cuspaceflight/avionics14/README.md

# CUSF Avionics 2014

## Firmware Compilation

Designed to be compiled with the GNU ARM Toolchain - https://launchpad.net/gcc-arm-embedded

The project should simply compile with

    make
