cuspaceflight/avionics14/TO_CHECK.md

# Badger 3 Testing List

## Things That Are Ok
* Magno
* Accel
* Baro
* LEDs
* Buzzer (with resistor removed)
* Pyro channels
* Radio

## Untested
* SD Card
* GPS

## Issues
* Gyro not responding on I2C
