cuspaceflight/avionics14/docs/states.png

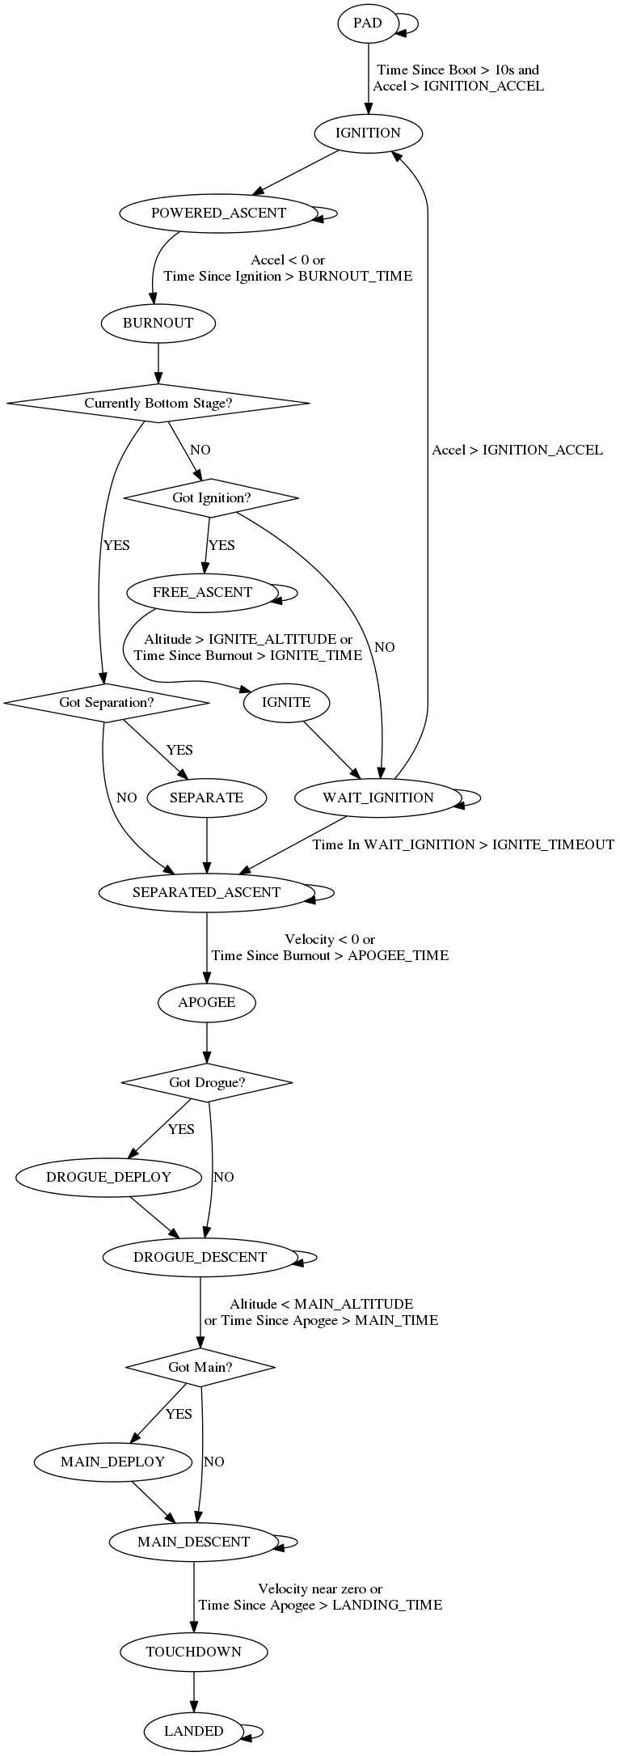
docs/states.png
