cuspaceflight/avionics14/pcb/pcbcase.dxf

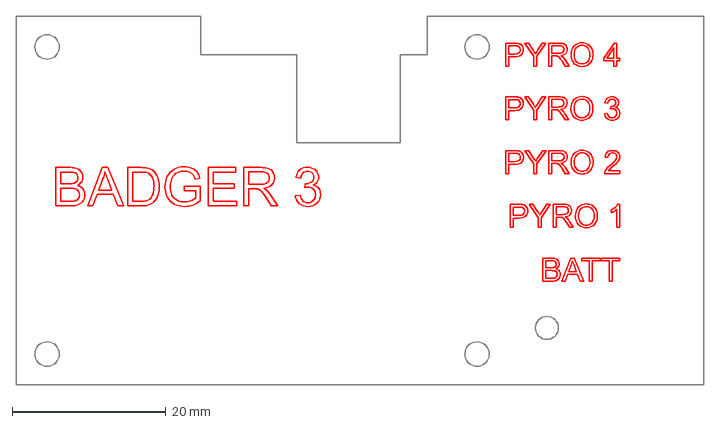
[picture p9: CAD file, 2015-06-05]
pcb/pcbcase.dxf
89.5 x 48.0 mm
