cuspaceflight/avionics14/firmware/tests/README.md

We should have some tests at some point ...
