cuspaceflight/avionics14/(threads)

Thread 13 (2015-08-19):

Race condition fix probably worse than cure

adamgreig, 2015-08-19:
https://github.com/cuspaceflight/avionics14/blob/master/firmware/adxl3x5.c#L282-L286

Looks like we lock before sleeping and hold the lock until we wake up from timeout. Should be enough to just have the interrupt check the thread it has a handle on is not already awake.
