cuspaceflight/avionics14/pcb/avionics.kicad_pcb

## KiCad design pcb/avionics.kicad_pcb (2015-05-06)

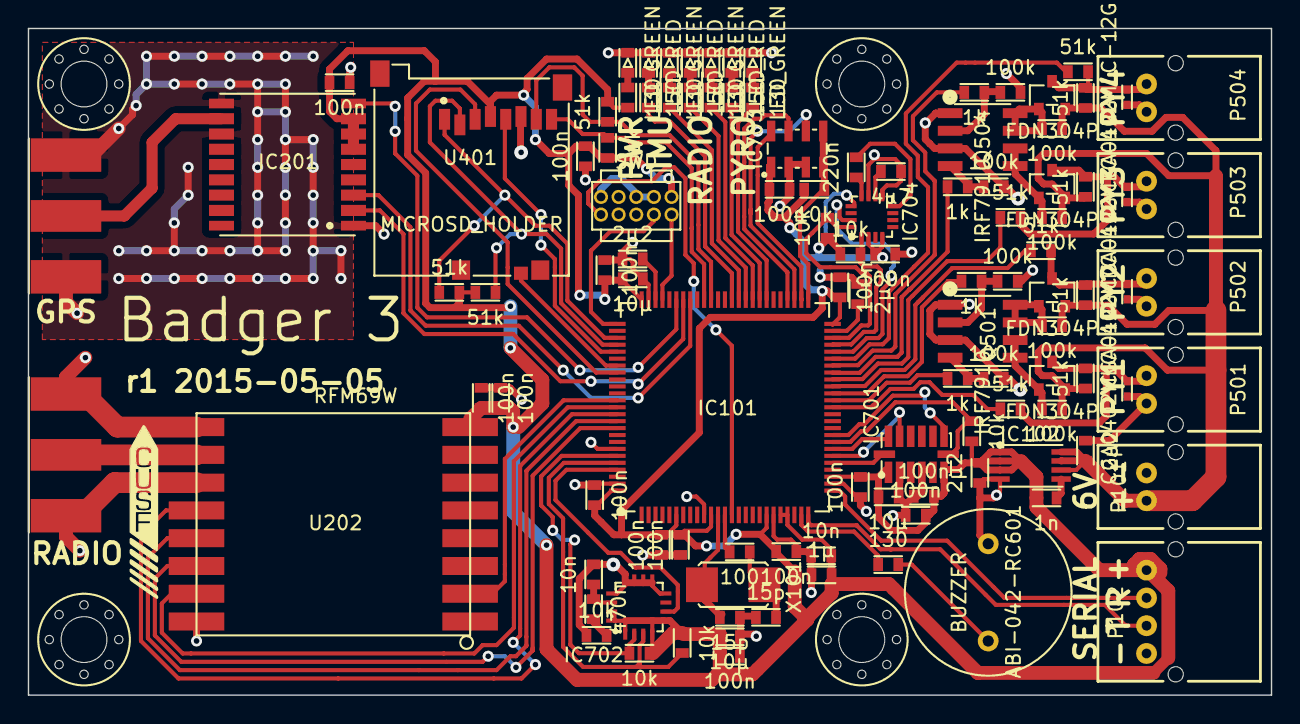
[picture p10: board avionics.kicad_pcb from above]

Board: 2 copper layers, 89.5 x 48.0 mm, 113 parts (0 on the bottom side), 86 nets.

Parts:
ABI-042-RC601: BUZZER; ABI-042-RC
C101, C701, C702: 10µ; 0603
C102, C103, C105, C109, C110, C112, C114, C201, C203, C204, C401, C703, C704, C705, C708, C709: 100n; 0603
C104: 1µ; 0603
C106, C107: 15p; 0603
C108, C706: 10n; 0603
C111, C113, C115, C117: 2µ2; 0603
C116: 1n; 0603
C707: 470n; 0603
C710: 4µ7; 0603
C711: 220n; 0603
D501, D502, D503, D504: CGA0402MLC-12G; R0402
D601, D603, D605, D607: LED_GREEN; 0603_LED
D602, D604, D606: LED_RED; 0603_LED
IC101: STM32F405VGT; LQFP100
IC102: ADP3335; MSOP8
IC201: MAX-7Q
IC701: ADXL345; ADXL3x5
IC702: L3G4200D
IC703: MS5611-01BA03; MS5611-01BA
IC704: HMC5883L
M3_MOUNT, M3_MOUNT#2, M3_MOUNT#3, M3_MOUNT#4: VAL**; M3_MOUNT
P101, P501, P502, P503, P504: CONN_01X02; S02B-PASK-2
P102: CONN_01X04; S04B-PASK-2
P103: SWD; FTSH-105-01-F-D-K
P201, P202: SMA; SMA-142-0701-801
Q501, Q504: IRF7910; SO-8
Q502, Q503, Q505, Q506: FDN304P; SOT23
R101: 100; 0603
R401, R402, R403, R404, R507, R508, R509, R510, R517, R518, R519, R520: 51k; 0603
R501, R502, R511, R512: 1k; 0603
R503, R504, R505, R506, R513, R514, R515, R516: 100k; 0603
R601, R603, R605, R607, R608: 130; 0603
R602, R604, R606: 150; 0603
R701, R702, R703, R704, R705, R706, R707: 10k; 0603
U202: RFM69W; rfm69w
U401: MICROSD_HOLDER; MEM2051
X101: 8M; XTAL50x32

Connections:
+3V3: C101.1, C102.1, C103.1, C104.1, C105.1, C108.1, C109.1, C110.1, C112.1, C114.1, C116.1, C117.1, C201.1, C203.1, C204.1, C401.1, C701.1, C702.1, C703.1, C704.1, C705.1, C708.1, C709.1, IC101.6, IC101.11, IC101.19, IC101.21, IC101.22, IC101.28, IC101.50, IC101.75, IC101.100, IC102.1, IC102.2, IC102.3, IC201.6, IC201.7, IC201.8, IC701.1, IC701.6, IC702.1, IC702.4, IC702.5, IC702.15, IC702.16, IC703.1, IC704.2, IC704.4, IC704.13, P102.1, P103.1, R401.1, R402.1, R403.1, R404.1, R607.1, R701.2, R702.2, R703.1, R705.2, R706.1, R707.2, U202.8, U401.4
+BATT: C115.1, IC102.6, IC102.7, IC102.8, P101.2, Q502.2, Q503.2, Q505.2, Q506.2, R505.2, R506.2, R507.2, R508.2, R515.2, R516.2, R517.2, R518.2
/Datalogging & Pyros/BUZZER: IC101.24, R608.2
/Datalogging & Pyros/IMU_OK: IC101.61, R603.1
/Datalogging & Pyros/PY1_TRG: IC101.39, R501.1
/Datalogging & Pyros/PY2_TRG: IC101.40, R511.1
/Datalogging & Pyros/PY3_TRG: IC101.43, R502.1
/Datalogging & Pyros/PY4_TRG: IC101.44, R512.1
/Datalogging & Pyros/PY_OK: IC101.57, R601.1
/Datalogging & Pyros/RADIO_OK: IC101.59, R605.1
/Datalogging & Pyros/~IMU_OK: IC101.62, R604.1
/Datalogging & Pyros/~PY1_CHK: IC101.38, R509.2
/Datalogging & Pyros/~PY2_CHK: IC101.41, R519.2
/Datalogging & Pyros/~PY3_CHK: IC101.42, R510.2
/Datalogging & Pyros/~PY4_CHK: IC101.45, R520.2
/Datalogging & Pyros/~PY_OK: IC101.58, R602.1
/Datalogging & Pyros/~RADIO_OK: IC101.60, R606.1
/Datalogging & Pyros/µSD_CD: IC101.82, U401.9
/Datalogging & Pyros/µSD_CLK: IC101.80, U401.5
/Datalogging & Pyros/µSD_CMD: IC101.83, U401.3
/Datalogging & Pyros/µSD_DAT0: IC101.65, R401.2, U401.7
/Datalogging & Pyros/µSD_DAT1: IC101.66, R402.2, U401.8
/Datalogging & Pyros/µSD_DAT2: IC101.78, R403.2, U401.1
/Datalogging & Pyros/µSD_DAT3: IC101.79, R404.2, U401.2
/EXT_RX: IC101.26, P102.2
/EXT_TX: IC101.25, P102.3
/Inertial Measurement/ACCEL_CS: IC101.33, IC701.7, R703.2
/Inertial Measurement/ACCEL_INT: IC101.34, IC701.8
/Inertial Measurement/ACCEL_MISO: IC101.31, IC701.12
/Inertial Measurement/ACCEL_MOSI: IC101.32, IC701.13
/Inertial Measurement/ACCEL_SCK: IC101.30, IC701.14
/Inertial Measurement/BARO_CS: IC101.51, IC703.4, IC703.5, R706.2
/Inertial Measurement/BARO_MISO: IC101.53, IC703.6
/Inertial Measurement/BARO_MOSI: IC101.54, IC703.7
/Inertial Measurement/BARO_SCK: IC101.52, IC703.8
/Inertial Measurement/GYRO_DRDY: IC101.97, IC702.6
/Inertial Measurement/GYRO_SCL: IC101.95, IC702.2, R701.1
/Inertial Measurement/GYRO_SDA: IC101.96, IC702.3, R702.1
/Inertial Measurement/MAGNO_DRDY: IC101.46, IC704.15
/Inertial Measurement/MAGNO_SCL: IC101.47, IC704.1, R705.1
/Inertial Measurement/MAGNO_SDA: IC101.48, IC704.16, R707.1
/Radio/GPS_nRST: IC101.70, IC201.9
/Radio/RADIO_CLK: IC101.89, U202.12
/Radio/RADIO_CS: IC101.88, U202.15
/Radio/RADIO_IRQ: IC101.87, U202.2
/Radio/RADIO_MISO: IC101.90, U202.13
/Radio/RADIO_MOSI: IC101.91, U202.14
/Radio/RX: IC101.68, IC201.3
/Radio/TX: IC101.69, IC201.2
/SWDCLK: IC101.76, P103.4
/SWDIO: IC101.72, P103.2
/nReset: IC101.14, P103.10
GND: ABI-042-RC601.2, C101.2, C102.2, C103.2, C104.2, C105.2, C106.2, C107.2, C108.2, C109.2, C110.2, C111.2, C112.2, C113.2, C114.2, C115.2, C117.2, C201.2, C203.2, C204.2, C401.2, C701.2, C702.2, C703.2, C704.2, C705.2, C706.1, C708.2, C709.2, C710.2, D501.2, D502.2, D503.2, D504.2, D601.2, D602.2, D603.2, D604.2, D605.2, D606.2, D607.2, IC101.10, IC101.20, IC101.27, IC101.74, IC101.94, IC101.99, IC102.4, IC201.1, IC201.10, IC201.12, IC701.2, IC701.4, IC701.5, IC702.8, IC702.9, IC702.10, IC702.11, IC702.12, IC702.13, IC703.2, IC703.3, IC704.9, IC704.11, P101.1, P102.4, P103.3, P103.5, P103.9, P201.2, P201.3, P201.4, P201.5, P202.2, P202.3, P202.4, P202.5, P501.2, P502.2, P503.2, P504.2, Q501.1, Q501.3, Q504.1, Q504.3, R503.1, R504.1, R513.1, R514.1, R704.2, U202.9, U202.11, U202.16, U401.6
unnamed: ABI-042-RC601.1, R608.1
unnamed: C106.1, IC101.12, X101.1
unnamed: C107.1, R101.2, X101.2
unnamed: C111.1, IC101.49
unnamed: C113.1, IC101.73
unnamed: C116.2, IC102.5
unnamed: C706.2, C707.2, IC702.14
unnamed: C707.1, R704.1
unnamed: C710.1, IC704.10
unnamed: C711.1, IC704.8
unnamed: C711.2, IC704.12
unnamed: D501.1, P501.1, Q502.3, R507.1, R509.1
unnamed: D502.1, P502.1, Q505.3, R517.1, R519.1
unnamed: D503.1, P503.1, Q503.3, R508.1, R510.1
unnamed: D504.1, P504.1, Q506.3, R518.1, R520.1
unnamed: D601.1, R601.2
unnamed: D602.1, R602.2
unnamed: D603.1, R603.2
unnamed: D604.1, R604.2
unnamed: D605.1, R605.2
unnamed: D606.1, R606.2
unnamed: D607.1, R607.2
unnamed: IC101.13, R101.1
unnamed: IC201.11, P201.1
unnamed: P202.1, U202.10
unnamed: Q501.2, R511.2, R513.2
unnamed: Q501.4, R501.2, R503.2
unnamed: Q501.5, Q501.6, Q502.1, R505.1
unnamed: Q501.7, Q501.8, Q505.1, R515.1
unnamed: Q503.1, Q504.5, Q504.6, R506.1
unnamed: Q504.2, R512.2, R514.2
unnamed: Q504.4, R502.2, R504.2
unnamed: Q504.7, Q504.8, Q506.1, R516.1
