cuspaceflight/avionics14/firmware/ublox.c

/*
 * uBlox GPS receiver
 * M2R
 * 2014 Adam Greig, Cambridge University Spaceflight
 */

/*
 * TODO
 *
 * * Read large buffers up to the number of bytes available from the ublox
 * * Run each new byte through a decoding state machine
 * * SM calls various functions to deal with each type of received message
 * * * Either ACK/NAK, PVT, or perhaps also CFG-NAV5
 * * Should poll the device's NAV5 at least once to ensure flight mode
 * * PVT updates get sent to central dispatch
 * * ACKs are OK but receiving a NAK is cause for sadness and logs
 */

#include <stdlib.h>
#include <string.h>
#include "ublox.h"
#include "hal.h"
#include "datalogging.h"
#include "tweeter.h"

/* UBX sync bytes */
#define UBX_SYNC1 0xB5
#define UBX_SYNC2 0x62

/* UBX Classes */
#define UBX_NAV 0x01
#define UBX_RXM 0x02
#define UBX_INF 0x04
#define UBX_ACK 0x05
#define UBX_CFG 0x06
#define UBX_UPD 0x09
#define UBX_MON 0x0A
#define UBX_AID 0x0B
#define UBX_TIM 0x0D
#define UBX_MGA 0x13
#define UBX_LOG 0x21
#define NMEA_CLASS 0xF0

/* Selection of UBX IDs */
#define UBX_CFG_MSG  0x01
#define UBX_CFG_NAV5 0x24
#define UBX_NAV_PVT  0x07
#define NMEA_GGA 0x00
#define NMEA_GLL 0x01
#define NMEA_GSA 0x02
#define NMEA_GSV 0x03
#define NMEA_RMC 0x04
#define NMEA_VTG 0x05

/* UBX Decoding State Machine States */
typedef enum {
    STATE_IDLE = 0, STATE_SYNC1, STATE_SYNC2,
    STATE_CLASS, STATE_ID, STATE_L1, STATE_L2,
    STATE_PAYLOAD, STATE_PAYLOAD_DONE, STATE_CK_A,
    NUM_STATES
} ubx_state;

/* Structs for various UBX messages */

/* UBX-CFG-NAV5
 * Set navigation fix settings.
 * Notably includes changing dynamic mode to "Airborne 4G".
 */
typedef struct {
    union {
        uint8_t data;
        uint8_t sync1;
    };
    uint8_t sync2, class, id;
    uint16_t length;
    union {
        uint8_t payload[36];
        struct {
            uint16_t mask;
            uint8_t dyn_model;
            uint8_t fix_mode;
            int32_t fixed_alt;
            uint32_t fixed_alt_var;
            int8_t min_elev;
            uint8_t dr_limit;
            uint16_t p_dop, t_dop, p_acc, t_acc;
            uint8_t static_hold_thres;
            uint8_t dgps_timeout;
            uint8_t cno_thresh_num_svs, cno_thresh;
            uint16_t reserved;
            uint16_t static_hold_max_dist;
            uint8_t utc_standard;
            uint8_t reserved3;
            uint32_t reserved4;
        } __attribute__((packed));
    };
    uint8_t ck_a, ck_b;
} ubx_cfg_nav5_t;

/* UBX-CFG-MSG
 * Change rate (or disable) automatic delivery of messages
 * to the current port.
 */
typedef struct {
    union {
        uint8_t data;
        uint8_t sync1;
    };
    uint8_t sync2, class, id;
    uint16_t length;
    union {
        uint8_t payload[3];
        struct {
            uint8_t msg_class;
            uint8_t msg_id;
            uint8_t rate;
        } __attribute__((packed));
    };
    uint8_t ck_a, ck_b;
} ubx_cfg_msg_t;

/* UBX-ACK
 * ACK/NAK messages after trying to set a config.
 */
typedef struct {
    union {
        uint8_t data;
        uint8_t sync1;
    };
    uint8_t sync2, class, id;
    uint16_t length;
    union {
        uint8_t payload[2];
        struct {
            uint8_t cls_id;
            uint8_t msg_id;
        } __attribute__((packed));
    };
    uint8_t ck_a, ck_b;
} ubx_ack_t;

/* UBX-NAV-PVT
 * Contains fix quality, position and time information.
 * Everything you want in one message.
 */
typedef struct {
    union {
        uint8_t data;
        uint8_t sync1;
    };
    uint8_t sync2, class, id;
    uint16_t length;
    union {
        uint8_t payload[92];
        struct {
            uint32_t i_tow;
            uint16_t year;
            uint8_t month, day, hour, minute, second;
            uint8_t valid;
            uint32_t t_acc;
            int32_t nano;
            uint8_t fix_type;
            uint8_t flags;
            uint8_t reserved1;
            uint8_t num_sv;
            int32_t lon, lat;
            int32_t height, h_msl;
            uint32_t h_acc, v_acc;
            int32_t velN, velE, velD, gspeed;
            int32_t head_mot;
            uint32_t s_acc;
            uint32_t head_acc;
            uint16_t p_dop;
            uint16_t reserved2;
            uint32_t reserved3;
            int32_t head_veh;
            uint32_t reserved4;
        } __attribute__((packed));
    };
    uint8_t ck_a, ck_b;
} ubx_nav_pvt_t;

static void ublox_warn(const uint8_t n)
{
    uint8_t i;
    for(i=0; i<n; i++) {
        palSetPad(GPIOD, GPIOD_RADIO_RED);
        chThdSleepMilliseconds(100);
        palClearPad(GPIOD, GPIOD_RADIO_RED);
        chThdSleepMilliseconds(200);
    }
}

static void ublox_error(const uint8_t n)
{
    tweeter_set_error(ERROR_GPS, true);
    while(1) {
        ublox_warn(n);
    }
}

/* Computes the Fletcher-8 checksum over buf, using its length fields
 * to determine how much to read and where to insert the new checksum.
 */
static void ublox_checksum(uint8_t *buf)
{
    uint16_t plen, i;
    uint8_t ck_a = 0x00, ck_b = 0x00;

    /* Check SYNC bytes are correct */
    if(buf[0] != UBX_SYNC1 && buf[1] != UBX_SYNC2)
        return;

    /* Extract payload length */
    plen = ((uint16_t*)buf)[2];

    /* Run Fletcher-8 algorithm */
    for(i=2; i<plen+6; i++) {
        ck_a += buf[i];
        ck_b += ck_a;
    }

    /* Write new checksum to the buffer */
    buf[plen+6] = ck_a;
    buf[plen+7] = ck_b;
}

/* Transmit a UBX message over the serial port.
 * Message length is determined from the UBX length field.
 * Checksum is added automatically.
 */
static bool_t ublox_transmit(uint8_t *buf)
{
    size_t n;
    systime_t timeout;

    /* Add checksum to outgoing message */
    ublox_checksum(buf);

    /* Determine length and thus suitable timeout in systicks (ms) */
    n = 8 + ((uint16_t*)buf)[2];
    timeout = n / 100 + 10;

    /* Transmit message */
    return sdWriteTimeout(&SD1, buf, n, timeout) == n;
}

/* Attempt to read one or more messages from the uBlox.
 * Returns 0 if no messages were read, else returns the number of bytes
 * read. Will read at most bufsize bytes into buf.
 */
static size_t ublox_receive(uint8_t *buf, size_t bufsize)
{
    return sdReadTimeout(&SD1, buf, bufsize, TIME_IMMEDIATE);
}

/* Run the first `num_new_bytes` bytes in `buf` through the UBX decoding state
 * machine. Note that this function preserves static state and dispatches new
 * messages as appropriate once received.
 */
static void ublox_state_machine(uint8_t *buf, size_t num_new_bytes)
{
    size_t i;
    static ubx_state state = STATE_IDLE;

    static uint8_t class, id;
    static uint16_t length;
    static uint16_t length_remaining;
    static char payload[128];
    static uint8_t ck_a, ck_b;

    ubx_cfg_nav5_t cfg_nav5;
    ubx_nav_pvt_t nav_pvt;
    ublox_pvt_t pvt;
    
    for(i = 0; i < num_new_bytes; i++) {
        uint8_t b = buf[i];

        switch(state) {
            case STATE_IDLE:
                if(b == UBX_SYNC1)
                    state = STATE_SYNC1;
                break;

            case STATE_SYNC1:
                if(b == UBX_SYNC2)
                    state = STATE_SYNC2;
                else
                    state = STATE_IDLE;
                break;

            case STATE_SYNC2:
                class = b;
                state = STATE_CLASS;
                break;

            case STATE_CLASS:
                id = b;
                state = STATE_ID;
                break;

            case STATE_ID:
                length = (uint16_t)b;
                state = STATE_L1;
                break;

            case STATE_L1:
                length |= (uint16_t)b << 8;
                if(length >= 128) {
                    state = STATE_IDLE;
                }
                length_remaining = length;
                state = STATE_PAYLOAD;
                break;

            case STATE_PAYLOAD:
                if(length_remaining)
                    payload[length - length_remaining--] = b;
                else
                    state = STATE_PAYLOAD_DONE;
                break;
            
            case STATE_PAYLOAD_DONE:
                ck_a = b;
                state = STATE_CK_A;
                break;

            case STATE_CK_A:
                ck_b = b;
                (void)ck_a;
                (void)ck_b;
                /* TODO check checksum */
                state = STATE_IDLE;
                switch(class) {
                    case UBX_ACK:
                        if(id == 0x00) {
                            /* NAK */
                            /* TODO be very sad */
                            ublox_error(3);
                        } else if(id == 0x01) {
                            /* ACK */
                            /* No need to do anything */
                        } else {
                            /* TODO SAD */
                            ublox_error(3);
                        }
                        break;
                    case UBX_NAV:
                        if(id == 0x07) {
                            /* PVT */
                            memcpy(nav_pvt.payload, payload, length);
                            memcpy(&pvt, payload, length);
                            palSetPad(GPIOD, GPIOD_RADIO_GRN);
                            chThdSleepMilliseconds(100);
                            palClearPad(GPIOD, GPIOD_RADIO_GRN);
                            log_u8(CHAN_GPS_TIME,
                                   (uint8_t)(pvt.year & 0xFF),
                                   (uint8_t)(pvt.year>>8 & 0xFF),
                                   pvt.month, pvt.day, pvt.hour, pvt.minute,
                                   pvt.second, pvt.valid);
                            log_s32(CHAN_GPS_POS, pvt.lat, pvt.lon);
                            log_s32(CHAN_GPS_ALT, pvt.height, pvt.h_msl);
                            log_s8(CHAN_GPS_STATUS, pvt.fix_type, pvt.flags,
                                   pvt.num_sv, 0, 0, 0, 0, 0);
                            /* Send the PVT to dispatch */
                            /*dispatch_pvt(pvt);*/
                        } else {
                            /* TODO SAD */
                            ublox_error(3);
                        }
                        break;
                    case UBX_CFG:
                        if(id == 0x24) {
                            /* NAV5 */
                            memcpy(cfg_nav5.payload, payload, length);
                            /* Just check that Airborne is set, if not log a
                             * warning and try to set it again */
                        } else {
                            /* TODO SAD */
                            ublox_error(3);
                        }
                        break;
                    default:
                        /* TODO sad */
                        ublox_error(3);
                        break;
                }
                break;

            default:
                state = STATE_IDLE;
                /* TODO sad */
                ublox_error(3);
                break;

        }
    }
}

static bool_t ublox_init(void)
{
    ubx_cfg_nav5_t nav5;
    ubx_cfg_msg_t msg;
    bool_t success = TRUE;

    /* Set to Airborne <4g dynamic mode */
    nav5.sync1 = UBX_SYNC1;
    nav5.sync2 = UBX_SYNC2;
    nav5.class = UBX_CFG;
    nav5.id = UBX_CFG_NAV5;
    nav5.length = 36;

    nav5.mask = 1;
    nav5.dyn_model = 8;
    nav5.reserved3 = 0;
    nav5.reserved4 = 0;

    success &= ublox_transmit(&nav5.data);
    if(!success) return FALSE;

    /* Disable NMEA messages to serial */
    msg.sync1 = UBX_SYNC1;
    msg.sync2 = UBX_SYNC2;
    msg.class = UBX_CFG;
    msg.id = UBX_CFG_MSG;
    msg.length = 3;

    msg.msg_class = NMEA_CLASS;
    msg.msg_id    = NMEA_GGA;
    msg.rate      = 0;
    success &= ublox_transmit(&msg.data);
    if(!success) return FALSE;

    msg.msg_class = NMEA_CLASS;
    msg.msg_id    = NMEA_GLL;
    msg.rate      = 0;
    success &= ublox_transmit(&msg.data);
    if(!success) return FALSE;

    msg.msg_class = NMEA_CLASS;
    msg.msg_id    = NMEA_GSA;
    msg.rate      = 0;
    success &= ublox_transmit(&msg.data);
    if(!success) return FALSE;

    msg.msg_class = NMEA_CLASS;
    msg.msg_id    = NMEA_GSV;
    msg.rate      = 0;
    success &= ublox_transmit(&msg.data);
    if(!success) return FALSE;

    msg.msg_class = NMEA_CLASS;
    msg.msg_id    = NMEA_RMC;
    msg.rate      = 0;
    success &= ublox_transmit(&msg.data);
    if(!success) return FALSE;

    msg.msg_class = NMEA_CLASS;
    msg.msg_id    = NMEA_VTG;
    msg.rate      = 0;
    success &= ublox_transmit(&msg.data);
    if(!success) return FALSE;

    msg.msg_class = UBX_NAV;
    msg.msg_id    = UBX_NAV_PVT;
    msg.rate      = 1;
    success &= ublox_transmit(&msg.data);
    if(!success) return FALSE;

    return success;
}

msg_t ublox_thread(void* arg)
{
    (void)arg;
    const int bufsize = 512;
    uint8_t buf[bufsize];
    uint8_t n_rx;

    chRegSetThreadName("uBlox");

    /* We'll reset the uBlox so it's in a known state */
    palClearPad(GPIOA, GPIOA_GPS_RESET);
    chThdSleepMilliseconds(100);
    palSetPad(GPIOA, GPIOA_GPS_RESET);
    chThdSleepMilliseconds(500);

    static const SerialConfig sc = {
        9600, 0, USART_CR2_STOP1_BITS | USART_CR2_LINEN, 0};
    sdStart(&SD1, &sc);

    if(!ublox_init()) {
        ublox_error(5);
    }

    while(TRUE) {
        n_rx = ublox_receive(buf, bufsize);
        ublox_state_machine(buf, n_rx);
        chThdSleepMilliseconds(50);
    }
}
