cuspaceflight/avionics14/(commit log)

2014-11-06 add empty schematic sheets
    [avionics.sch, datalogging.sch, imu.sch, radio.sch]
2014-11-06 Added GPS module
    [radio.sch]
2014-11-06 Added a2235-h.lib
    [$radio.sch]
2014-11-06 Added minimimum spesifications
    [$radio.sch, radio.sch]
2014-11-06 GPS module
    Finished the GPS module and labeled the inputs/putputs
    [radio.sch]
2014-11-07 Setup up barebones ChibiOS project and added details to README.md on how to compile it.
    The configuration files are copied from Martlet 2 and so will likely need modification once the PCB design has been finalized.
2014-11-08 Created 3D translational kalman filter written in C that should easily be ported over to the STM32.
    I decided against using a matrix library as it seemed very wasteful given that most of the matrices were mainly 0s (the state transition matrix had 61). Instead I opted to handle the axes completely independently and write the matrix multiplications by hand.
    The barometer calibration was copied from the Martlet 2 repo as I didn't see any benefit to rewriting it. The covariance update was also copied as doing it again by hand seemed like a waste of time.
    [main.c]
2014-11-13 Added in schematics for 4 pyro channels since transistors come in pairs.
    [avionics.sch, datalogging.sch, imu.sch, pyro chn.sch, radio.sch]
2014-11-14 config: aaand, fixed the first bug
    [config.h]
2014-11-14 fixed state transition order
    [misson_control_top.c]
2014-11-15 MATLAB implementation of the QUEST algorithm for estimating the state quaternion based on accelerometer and magnetometer data which will then be fed into the orientation kalman filter. It works as fa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
2014-11-16 add rf module to schm
    [avionics.sch]
2014-11-16 add rf module to schematic
    [radio.sch]
2014-11-16 Update misson_control_top.c
    Was missing a state, so fixed this
    Top is no longer in control of firing the separation e-match
    [misson_control_top.c]
2014-11-16 Create pyro.c
    More of a template for the pyrotechnics driver
2014-11-19 Added continuity checks, fixed bugs
    [pyro.c]
2014-11-19 Missing resistor library component added. (Resistors are not square boxes!)
2014-11-24 SPI pins & receiver module
    [radio.sch]
2014-11-25 config: preliminary implementation of config. nothing too fancy.
    [example_config.txt]
2014-11-25 connections 2-6
    [radio.sch]
2014-11-26 config: this is more clear (and more correct)
    [config.c]
2014-11-26 Added on the transient suppressing diodes. I think we should use the 1SMB15AT3G diode, which is a quick response transient suppressing zener diode at 7.25p a piece, unless we order 25 pieces (which m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
    [avionics.sch, datalogging.sch, imu.sch, pyro chn.sch, radio.sch]
2014-11-26 Added in uSD hardware. I'm assuming we're using SPI, if not the pins have to be connected differently. uSD card holder is the MEM2051 in farnell. Not entirely sure about pullup resistors, and whether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
    [avionics.sch, datalogging.sch, imu.sch, pyro chn.sch, radio.sch, uSD.sch]
2014-11-28 config: now with basic test, wow.
    also changed signature of config_init (now accepts path to config
    as parameter).
    added basic check of whether the file is non-negative.
    [config_example.txt, example_config.txt]
2014-11-28 Added two channels for separation
    Also included an extra firing function to handle metrons as we need both to fire simultaneously and the current setup doesn't allow that.
    [pyro.c]
2014-11-28 antenna connector symbol
2014-11-28 labels & pullup values & antenna & decoupling
    [radio.sch]
2014-11-28 Resolved issues with Pyro Schematics + a little tidying up. - PMOS upside down - TVS diode for ESD (ESD8V0R1B-02LS at 2.18p each, 1.91p each (25-99), 1.72p each (100-249)) - Replaced Heirachial Pins 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
    [avionics.sch, datalogging.sch, imu.sch, pyro chn.sch, radio.sch, uSD.sch]
2014-11-28 Rectified microSD Card Hardware. - 51k pullups - SDIO configuration - TVSD removed - 100nF cap
    [datalogging.sch, uSD.sch]
2014-11-29 Added in Indicator LEDs (need some clarification) - Using the complementary CMOS FG6943010R (8p each) to drive indicator LEDs Others: - General cleanup to solve alignment problems (50mil grid) - Edit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
    [Indicators.sch, avionics.sch, datalogging.sch, imu.sch, pyro chn.sch, radio.sch, uSD.sch]
2014-11-29 Changed indicators to single pin single LED on advice. - Ran ERC and solved the large errors.
    [Indicators.sch, datalogging.sch, pyro chn.sch, uSD.sch]
2014-12-23 Corrected data processing for sensor readings
2015-01-09 Created a simple GUI for processing and viewing flight data in 3D.
    It currently accepts data in the Martlet 2 telemetry format and uses the sensor data to test out the state estimation algorithms (currently attitude is not calculated). It then renders this in 3D in realtime. Unfortunately without an actual board I can't properly calibrate the data, so it approximates the biases and scaling factors based on the data collected prior to ignition.
    The project is split into two main projects, Avionics and Avionics.GUI, the former being a C library containing code that should be easily ported to run on the STM32 and the latter containing all the C++ code for the GUI.
    Avionics.GUI has a few depen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
2015-01-17 add rfm69, changed gps schematic
    [radio.sch]
2015-01-23 Added buzzer to schematic to allow one more form of error reporting.
2015-01-23 Forgot to add the mods from the other files, sorry!
    [Indicators.sch, avionics.sch, datalogging.sch, imu.sch, pyro chn.sch, radio.sch, uSD.sch]
2015-01-25 Added test root widget for ground station
2015-02-03 updated groundstation
2015-02-03 removed old groundstation
2015-02-05 footprint files
2015-02-05 deleted old radio schematic
    [radio.sch]
2015-02-07 Created black box state estimator to accept raw data and handle calling the individual state estimators
    Fixed some problems with the Quest Algorithms output, some of the sequential rotations were incorrect causing the rotations around certain axis to be inverted
    Added ability to receive real time data over a serial port
    Added calibration MatLab scripts for magnetometers and accelerometers which uses an ellipsoid fitter I found online and a non-linear Gauss newton approach to correct for bias and scaling factors.
2015-02-09 update libraries and symbols
    [Indicators.sch, avionics.sch, datalogging.sch, imu.sch, pyro chn.sch, radio.sch, uSD.sch]
2015-02-09 export pins to main sheet, add IMU
    [Indicators.sch, avionics.sch, datalogging.sch, imu.sch, pyro chn.sch, radio.sch, uSD.sch]
2015-02-10 Added covariance estimation to the calibration MatLab scripts. This can then be used by the translation kalman filter. Brief tests have shown this gives much better results than the previous value.
    Added serial packet timestamp synchronization although for some reason this causes the simulation to lag noticeably behind.
    Added a start delimiter of the characters 'SY' to the serial data format.
    The bias values for the accelerometer (computed for the QUEST algorithm) are now subtracted from the accelerometer values before being fed into the kalman filter, as opposed to previously where gravity was just subtracted from the y axis.
2015-02-10 Added in a few footprints. Couldn't find the 0603 footprint in the default library, so created one. Haven't created footprints for caps and LEDs yet. Which ones are we using? Unsure of the connector 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
2015-02-10 update schematic after today's meeting
    [avionics.sch]
2015-02-13 connect pins to micrcontroller where we decided last meeting
    [avionics.sch]
2015-02-13 more schematic work
    [Indicators.sch, avionics.sch, imu.sch, pyro chn.sch, radio.sch, uSD.sch]
2015-02-15 Added in silkscreen for all mods and created a 0603 LED variation with polarity inscription.
2015-02-17 footprint assignment
    [Indicators.sch, avionics.kicad_pcb, avionics.sch, imu.sch, pyro chn.sch, radio.sch, uSD.sch]
2015-02-17 start pcb routing!!
    [Indicators.sch, avionics.kicad_pcb, avionics.sch, pyro chn.sch, uSD.sch]
2015-02-18 move sch libraries inside library folder
    [Indicators.sch, avionics.sch, datalogging.sch, imu.sch, pyro chn.sch, radio.sch, uSD.sch]
2015-02-18 swap GPS module to uBlox
    [Indicators.sch, avionics.kicad_pcb, avionics.sch, imu.sch, pyro chn.sch, radio.sch, uSD.sch]
2015-02-19 Added a flight data class to store the current values
2015-02-21 expose log functions to external threads
2015-02-21 fixed typo in location check
    [rfm69.c]
2015-02-23 Tried to do a bit of routing. Couldn't really make any progress. Probably have to use thinner tracks, and might have to hop across the layers.
    [avionics.kicad_pcb, pyro chn.sch]
2015-03-07 continue pyro routing
    [avionics.kicad_pcb, pyro chn.sch]
2015-03-08 Tried to route a little more of the board. Are the jumps ok?
    [avionics.kicad_pcb]
2015-03-09 routing after today's meeting
    [avionics.kicad_pcb, avionics.sch]
2015-03-10 Have continued routing the PCB. I have tried to make it more compact on the right side of the PCB. It is still possible to push it more togheter by moving the microcontroller into the gap to its righ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
    [avionics.kicad_pcb]
2015-03-11 moved the microprosessor closer to the right. If we rethink the bottom part of the circuit board we could possibly move it even further. If we want to do that we should probably get on with it as soo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
    [avionics.kicad_pcb]
2015-03-12 I have moved the microcontroller to what I believe is the optumum position. I have also changed the transistor for the buzzer to a 300R resistor and the buzzer pin to pin 24 PA1. I had to reconnect a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
    [Indicators.sch, avionics.kicad_pcb, avionics.sch, imu.sch]
2015-03-12 continued routing, note that we need to solve how to connect nReset and also how to power all the VDDs.
    [avionics.kicad_pcb]
2015-03-12 continued routing
    [avionics.kicad_pcb]
2015-03-12 tidied up some routing
    [Indicators.sch, avionics.kicad_pcb, avionics.sch]
2015-03-12 tidied some more stuff
    [avionics.kicad_pcb]
2015-03-12 yet more routing done!
    [avionics.kicad_pcb]
2015-03-13 Almost done. Just in case
    [avionics.kicad_pcb]
2015-03-13 WE'RE FINALLY DONE!!!
    [avionics.kicad_pcb]
2015-03-14 include config header, driver works when tested on dev board
2015-03-15 Edited silkscreen placements for IC chips on the board so that it would not overlap with pads, vias, or be illegible. Don't have the CUSF logo to put on though...
    [avionics.kicad_pcb]
2015-04-06 I have started a spreadsheet for helping us finish the pcb and order the correct components, please feel free to help me fill it out and check the footprints for the components
2015-04-26 Added orientation kalman filter which is working incredibly well. The only problem it has at the moment is when the yaw angle rolls over (from pi <-> -pi) it sometimes rotates in the opposite directi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
    Fixed QUEST sequential rotations method sometimes outputting an incorrect quaternion (with theta > pi)
    Removed euler angles from state estimate to avoid them being used for anything crucial
2015-04-27 Reworked gyro and magnetometer drivers to be more customizable and support more features. Magnetometer driver is based on the one found at https://github.com/DuinoPilot/trunetcopter and I tried to ma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
    Gyroscope driver doesn't yet perform automatic calibration but I plan to add this shortly.
    Updated ChibiOS to point to a stable branch rather than master (which I had accidentally set it to track).
    [chconf.h, ffconf.h, i2c_util.c, i2c_util.h, mcuconf.h]
2015-05-05 I have added the Farnell code to a series of sheets
    [avionics.sch, imu.sch, radio.sch]
2015-05-05 add farnell part numbers for datalogging
    [Indicators.sch, pyro chn.sch, uSD.sch]
2015-05-05 Added order numbers for all parts
    [avionics.sch, imu.sch]
2015-05-05 Added order codes for missing parts
    [avionics.sch, imu.sch, pyro chn.sch]
2015-05-06 ship it!
    [avionics-B_Cu.gbl, avionics-B_Mask.gbs, avionics-B_SilkS.gbo, avionics-Edge_Cuts.gbr, avionics-F_Cu.gtl, avionics-F_Mask.gts, avionics-F_SilkS.gto, avionics-NPTH.drl]
2015-05-06 add power led, change resistor for buzzer
    [Indicators.sch]
2015-05-06 add farnell # for xtal, remove to-do checklist
    [avionics.sch]
2015-05-06 100n not 100nF capacitor on uSD.sch
    [uSD.sch]
2015-05-06 10k not 10K resistor on imu.sch
    [imu.sch]
2015-05-06 satisfy kicad's urge to rearrange sch files
    [datalogging.sch]
2015-05-06 add farnell BOM
2015-05-06 new netlist for power LED
2015-05-06 add power LED
    [avionics.kicad_pcb]
2015-05-06 Improve power routing
    * remove long track on far right
    * thicken up main carrier on bottom
    * route GPS through decoupling cap
    [avionics.kicad_pcb]
2015-05-06 update chi's name
    [avionics.kicad_pcb]
2015-05-06 increase clearance around gps antenna trace
    [avionics-B_Cu.gbl, avionics-B_Mask.gbs, avionics-B_SilkS.gbo, avionics-Edge_Cuts.gbr, avionics-F_Cu.gtl, avionics-F_Mask.gts, avionics-F_SilkS.gto, avionics-NPTH.drl]
2015-05-06 make right angled track a 45o angle instead
    [avionics-B_Cu.gbl, avionics-B_Mask.gbs, avionics-B_SilkS.gbo, avionics-Edge_Cuts.gbr, avionics-F_Cu.gtl, avionics-F_Mask.gts, avionics-F_SilkS.gto, avionics-NPTH.drl]
2015-05-06 remove copper under magno
    [avionics-B_Cu.gbl, avionics-B_Mask.gbs, avionics-B_SilkS.gbo, avionics-Edge_Cuts.gbr, avionics-F_Cu.gtl, avionics-F_Mask.gts, avionics-F_SilkS.gto, avionics-NPTH.drl]
2015-05-06 tidy up removed copper under magno
    [avionics-B_Cu.gbl, avionics-B_Mask.gbs, avionics-B_SilkS.gbo, avionics-Edge_Cuts.gbr, avionics-F_Cu.gtl, avionics-F_Mask.gts, avionics-F_SilkS.gto, avionics-NPTH.drl]
2015-05-07 update with new format BOM
2015-05-07 update farnell part for green LED from a resistor to a green LED
    [Indicators.sch]
2015-05-07 update 2pin header P101 to RS (in-stock) code
    [avionics.sch]
2015-05-07 change to in-stock SMA connector
    [radio.sch]
2015-05-07 swap 1u capacitor from Y5V to X5R dielectric
    [avionics.sch]
2015-05-22 new firmware
    [config_example.txt]
2015-05-24 fix board.mk paths
2015-05-24 Added a LED test
2015-05-24 Fixed some stuff that I was mistaken about.
    [b3_shell.c]
2015-05-24 Added in the typecasting just in case.
2015-05-24 Added gyro testing. Gyro is not working.
    [b3_shell.c, main.c]
2015-05-25 doesn't work, look at datasheet
    [b3_shell.c, main.c]
2015-05-25 datalogging: fixed cache logic.
    the bool for checking cache status was named the opposite of what it should.
    also added a few more comments.
    [datalogging.c, datalogging.h]
2015-05-25 fixed bugs in pyro test
    [b3_shell.c, pyro.c]
2015-05-27 add GPS test and use both UART2 outputs
2015-05-27 radio pin allocations
2015-05-27 radio driver files
2015-05-27 set power amplifier 0 instead of 1
2015-05-27 change SPI functions, led indicators for initialisation
2015-05-27 sd pins board config + simple test
2015-05-27 Tried fixing the magno driver. Current values set for the magno are default. We'll probably want to increase the frequency of fetching, and adjust the gain depending on the magnetic field in the UK.
2015-05-28 datalogging: fixed read bug (reset file ptr, may need more flexibility).
    Test should be working ish. Although it still occasionally fails on
    file opening (timeout error + CRC check error). Need to investigate!
    [b3_shell.c, microsd.c, microsd.h]
2015-05-28 make board.h as sensible as possible for i2c
2015-05-28 Revert "store this nice working magno test code in a commit"
    This reverts commit 65a51313166a4cd027eda75cebae3e59f1787c54.
    [main.c]
2015-05-28 arduino receiver station
2015-05-28 removed thread
2015-05-28 swap to radio test thread
    [board.h, main.c]
2015-05-28 fix arduino include syntax
    [driver_test_server.ino, rfm69_config.h]
2015-05-28 run radio thread in main, call log function in test
2015-05-30 mission control for single stage
2015-05-30 changes to gyro - works on top board
2015-05-30 further magno/gyro playing
2015-05-30 Done with the Gyros. Should work.
2015-05-30 gyro works yay
2015-05-30 print hex over serial
2015-05-30 checksum + 2 x syncwords + fixed payload length of 17
    [rfm69_config.h]
2015-05-30 Tried to get some magno stuff modified. Using the successful Gyro code to assist!
2015-05-30 output the raw int16 from gyros
2015-05-30 800hz gyro pew pew
2015-05-31 Updated the magno driver. Should look very similar to the gyro.
2015-06-03 remove old driver
2015-06-03 fix all build warnings
    [adxl3x5.c, b3_shell.c, main.c, rfm69.c, rfm69_config.h, ublox.c, ublox.h]
2015-06-03 add WAIT_IGNITION state for cases when next stage is ignited by separation charge only
2015-06-04 implement state machine functions and update pyro driver to use new config settings
2015-06-05 autoformat arduino code
2015-06-05 add config thread
2015-06-05 rename datalogging thread; fix rf logging bug
    [datalogging.c, datalogging.h]
2015-06-05 fix DMA conflict with SDIO and SPI1
    [mcuconf.h]
2015-06-05 rename pyro thread
2015-06-05 add new threads to main.c
2015-06-05 check in the case drawings
    [pcbcase.dxf]
2015-06-05 fix potential sad race condition in accel/gyro driver
    [adxl3x5.c]
2015-06-05 tidy shell threads table formatting
2015-06-05 set config thread name
2015-06-05 send to radio before trying to save to sd card, in case can't save to sd card
2015-06-05 enable gyro thread
2015-06-05 fix alt issue if pressure>Pb[0]
    [state_estimation.c, state_estimation.h]
2015-06-06 add config control of radio, gyro, magno, gps
2015-06-06 swap config to mostly unsigned ints
    [b3_shell.c, config.c, config.h]
2015-06-06 add basic mission control testing framework
2015-10-19 set different frequencies based on which stage of the rocket flight computer sits in
2015-11-01 fix checksum and origin in datalogging
    [config.c, datalogging.c, datalogging.h]
2015-11-01 add first go at simple groundstation python
2015-11-01 calibrate out the pad altitude
2015-11-01 update ground station; send gyro radio packets
